Brandonh291/RC-Plane/README.md

# 3D Printed RC-Plane
This will be a full step-by-step production through all stages using systems engineering approach to create a 3D printed RC Plane.
