Brandonh291/RC-Plane/Systems Engineering/Pre-Phase A - Concept Studies/Pre-Phase A Concept Studies.docx

# Pre-Phase A: Concept Studies

Brandon Hickey

9/22/2023

Following: https://www.eng.auburn.edu/~dbeale/ESMDCourse/Chapter2.htm


# Purpose

The purpose of this section is to first create a list of ideas and concepts that satisfy the desired outcome and mission objectives. This will then be used in the 11 SE functions to derive a series of potential solutions.

# Systems Engineering Functions

Here I will attempt to go through each function and attempt to perform them at this stage.

## SE Function 1: Mission Objectives and Constraints

The goal of this project is to develop, design, and test a 3D printed remote-controlled aircraft capable of decent flight time and potential for payload. Due to the nature of the project, goals and requirements at this stage are ambiguous and lack many hard-set constraints. I will go through and list the current objectives and constraints and attempt to provide a range of required performance to then use moving forward in Phase A – Concept and Technology Development

## SE Function 2: Derived Requirements Development

### Project Objectives and Constraints List

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

### Identified Objectives and Constraints

- Made from 3D Printed Material.
- Individually printed pieces should not exceed 200mm x 200mm x 200mm.
- Aircraft wingspan to not exceed 1500mm.
- Electrical voltage will be either 2S or 3S Li-Po
- Aircraft Cruising speed: 9 – 13.5 m/s
- Vehicle weight less than 1,000 grams
- Thrust to weight ratio: 0.2 – 0.5.
- Motor Thrust: 200 – 500 grams
- Capable of flying for at least 10 minutes, 20 is preferred.
- Capable of carrying an extra 300-gram payload.

## SE Function 3: Architectural Design Development

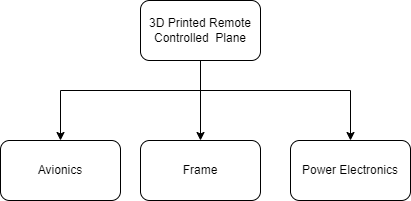
[picture p12: figure]

## SE Function 4: Concept of Operation


## SE Function 5: Validate and Verify

### Requirements Verification

To ensure we are satisfying our requirements, we will be performing basic calculations and testing to ensure we meet our requirements. This can include doing basic thrust and power calculations with a potential motor/prop combination to provide the desired T/W ratio as well as calculating our aircraft dimensions based on weight and desired speed.

### Systems Verification

We will be performing testing throughout development to ensure system operates safely and as expected. Such areas will include testing control surface directions and electronics wiring before the vehicle even approaches the runway.

### System Validation

Ensure that we are designing and developing according to the mission objectives and staying within our constraints.

## SE Function 6:

Not Completed, used later in Phase B.

## SE Function 7: Mission environment

Identify all environmental factors and potential concerns and exposures. For our aircraft we expect low winds (less than 10 mph), minimal weather.

## SE Function 8: Technical Resource Budget Tracking

Expected Budgets we plan to track during the project:

- Mass budget, this will help us keep track of the breakdown of object weights and where we might be able to trim potential issues.
- Cost Budget, keeping track of costs is important.
- Power Budget, this might be good to keep track of our power consumption to give a good breakdown of flight time estimation.

## SE Function 9: Risk Management

We will perform the following in the project.

- Seek and Identify risks.
- Determine risk severity and effect.
- Develop methods of risk mitigation

## SE Function 10: Configuration Management and Documentation

All content except Fusion360 files will be stored in GitHub. Project management will also be done through GitHub to maintain traceability. If Fusion360 files are added, they can be uploaded daily with provided changes.

## SE Function 11: System Milestone Reviews and Reports

As I am the stakeholder, my reviews are kind of to myself? I can mark milestones using GitHub to identify major areas of the project such as finishing phases and scheduled testing dates.
