Brandonh291/RC-Plane/Systems Engineering/Phase B - Preliminary Design and Technology Completition/Technical Resource Tracking.xlsx

Sheet: Mass Budget
Max Mass (g) | 1000
Current Total Mass | 1056.65
 |  |  |  |  |  | Aircraft Frame Part Weight
Subsystem | Avionics | Subsystem | Power | Subsystem | Aircraft Frame | Aircraft Wing |  | Aircraft Fuselage
Object | Mass (g) | Object | Mass (g) | Object | Mass (g) | Object | Mass (g) | Object | Mass (g)
FS-iA6B Receiver | 14.9 | D2830 1000KV Brushless Motor | 52 | Wings | 338.5 | Leading Edge | 34 | Nose | 67
SG90 Servo (4x) | 36 | 40A RC and 3A UBEC | 48 | Body | 447.25 | Trailing Edge | 12 | Middle | 104
 |  | 3S Lipo 2200mAh | 120 | Landing Gear | ? | Aileron | 33 | Inner Tail | 64
 |  |  |  |  |  | Rear Spar | 17 | Outer Tail | 31
 |  |  |  |  |  | Front Spar | 21 | Horizontal Stabilizers | 54
 |  |  |  |  |  | Ribs | 37 | Elevator | 21
 |  |  |  |  |  | End Cap Rib | 11 | 15.7 Inch 3mm Carbon Rod | 4.25
 |  |  |  |  |  | 15.7 Inch 3mm Carbon Rod | 4.25 | Fin and Rudder | 32
 |  |  |  |  |  |  |  | 1000mm x 8mm Carbon Tube x2 | 70
Total | 50.9 | Total | 220 | Total | 785.75 | Total | 338.5 | Total | 447.25

Sheet: Cost
Max Cost
Total Cost | 66.5
Subsystem | Avionics | Subsystem | Power | Subsystem | Aircraft Frame
Object | Cost ($) | Object | Cost ($) | Object | Cost ($)
FS-iA6B Receiver | 17
SG90 Servo (4x) | 10 | 40A RC and 3A UBEC | 22
 |  | 3S Lipo 2200mAh | 17.5
Total | 27 | Total | 39.5 | Total | 0
