Brandonh291/RC-Plane/Systems Engineering/Phase B - Preliminary Design and Technology Completition/Trainer Design Study.xlsx

Sheet: Plane Lift Study V1
Air Viscosity (kg/m/s) | 1.79e-05
Air Density (kg/m/m/m) | 1.225
Lift | S7055 Flatbottom
Reynolds Number | Alpha = 0 deg | Alpha = 5 deg | Alpha = 10 deg
50000 | 0.0812 | 0.6619 | 1.2661
100000 | 0.3952 | 0.8992 | 1.2615 |  |  |  |  |  | Here we will make all Lift greater than 1 kg (9.81 N) equal to yellow, to indicate a possible cruising condition at 1 kg plane weight
200000 | 0.4304 | 0.9118 | 1.2591 |  |  |  |  |  | We will mark anything greater than 13 N as green to indicate that it can handle the full 1kg plane and 300 gram payload
 |  |  |  |  |  |  |  |  | Aspect Ratio 5, Lift By Wingspan @ 9 m/s cruising
250 mm Wingspan |  |  |  |  |  |  |  |  | Wingspan (mm) | 9m/s Lift (N) @ Alpha = 0 | 9m/s Lift(N) @ Alpha = 5 | 9m/s Lift(N) @ Alpha = 10
Inputs |  |  | Outputs |  |  |  |  |  | 0.25 | 0.0503566875 | 0.4104814219 | 0.7851798281
Wingspan (m) | Wing Aspect Ratio | Cruising Speed (m/s) | Average Wing Chord (m) | Wing Area (m^2) | Reynolds Number | Lift (N) @ Alpha = 0 | Lift(N) @ Alpha = 5 | Lift(N) @ Alpha = 10 | 0.5 | 0.20142675 | 1.641925688 | 3.140719313
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
