Brandonh291/RC-Plane/Systems Engineering/Phase B - Preliminary Design and Technology Completition/Trade Study.xlsx

Criteria | Weight | Opt. #1 Twin Boom, One Engine |  | Opt. #2 Twin Boom, Two Engine |  | Opt. #3 Trainer, High-wing, Single Engine |  | Opt. #4 C130 Style, High-Wing, Two Engine |  | Criteria | Weight | Twin Boom 1E | Twin Boom 2E | Trainer 1E | Trainer 2E
 |  | Rating (1-5) | Score | Rating (1-5) | Score | Rating (1-5) | Score | Rating (1-5) | Score |  |  | Score | Score | Score | Score
Expected Ease of Designing | 15 | 2 | 6 | 1 | 3 | 4 | 12 | 3 | 9 | Expected Ease of Designing | 15 | 6 | 3 | 12 | 9
Expected Ease of Manufacturing | 10 | 3 | 6 | 2 | 4 | 4 | 8 | 3 | 6 | Expected Ease of Manufacturing | 10 | 6 | 4 | 8 | 6
Expected Ease of assembling | 15 | 2 | 6 | 1 | 3 | 3 | 9 | 2 | 6 | Expected Ease of assembling | 15 | 6 | 3 | 9 | 6
Durability/Rigidity | 10 | 4 | 8 | 3 | 6 | 4 | 8 | 3 | 6 | Durability/Rigidity | 10 | 8 | 6 | 8 | 6
Maneuverability | 10 | 4 | 8 | 5 | 10 | 3 | 6 | 3 | 6 | Maneuverability | 10 | 8 | 10 | 6 | 6
Aesthetic/Personal Taste | 5 | 3 | 3 | 4 | 4 | 2 | 2 | 4 | 4 | Aesthetic/Personal Taste | 5 | 3 | 4 | 2 | 4
Stability | 15 | 3 | 9 | 3 | 9 | 4 | 12 | 4 | 12 | Stability | 15 | 9 | 9 | 12 | 12
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
