Brandonh291/RC-Plane/Systems Engineering/Phase B - Preliminary Design and Technology Completition/Specifications.xlsx

Phase-B Specifications
Specification | Value | Unit
Material | 3D Printed (PLA / LW-PLA) | N/A
Individual Part Size | <200 x 200 x 200 | millimeters
Wingspan | <1500 | millimeters
Battery | 3S Lipo | N/A
Cruising Speed | 9 - 17 | meters per second
Aircraft Weight | <1000 | grams
Thrust to Weight Ratio | 0.2 - 0.5 | N/A
Flight Time | 10 - 20 | minutes
Payload Capacity | ~300 | grams
Runway Take-off Length | <50 | meters
