Brandonh291/RC-Plane/Systems Engineering/Phase B - Preliminary Design and Technology Completition/Fusion360 Versions/3D Models/Version 1/Fuselage/Fuselage_Nose.stl

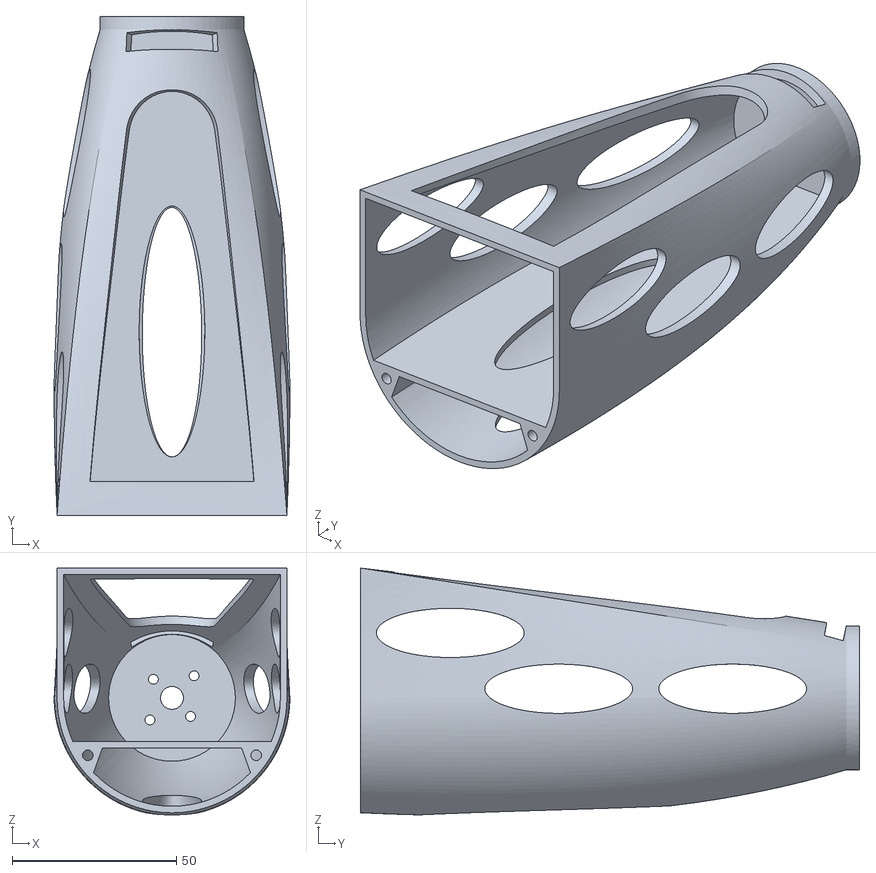
[picture p13: CAD file, 2023-10-05]
Systems Engineering/Phase B - Preliminary Design and Technology Completition/Fusion360 Versions/3D Models/Version 1/Fuselage/Fuselage_Nose.stl
71.8 x 152.0 x 75.2
