Brandonh291/RC-Plane/Systems Engineering/Phase B - Preliminary Design and Technology Completition/Fusion360 Versions/3D Models/Version 1/Fuselage/Tail/Front Tail.stl

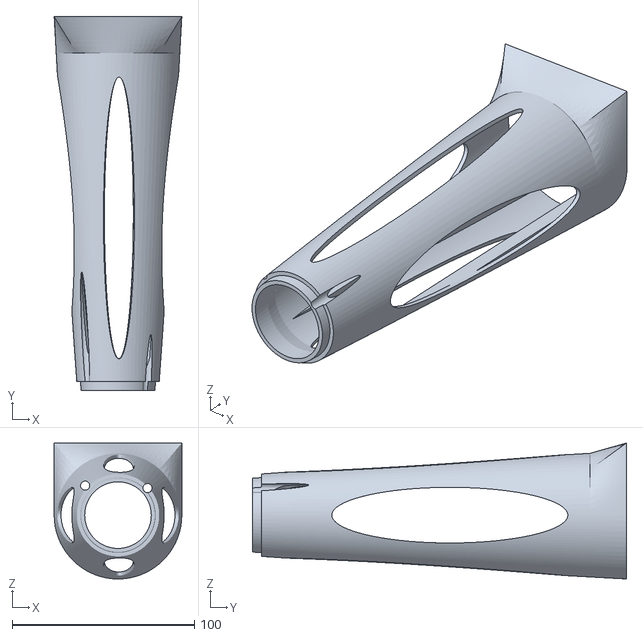
[picture p14: CAD file, 2023-10-05]
Systems Engineering/Phase B - Preliminary Design and Technology Completition/Fusion360 Versions/3D Models/Version 1/Fuselage/Tail/Front Tail.stl
70.0 x 205.0 x 74.5
