Brandonh291/RC-Plane/Systems Engineering/Phase B - Preliminary Design and Technology Completition/Fusion360 Versions/3D Models/Version 1/Fuselage/Tail/Horizontal Stabilizer/Left Stab.stl

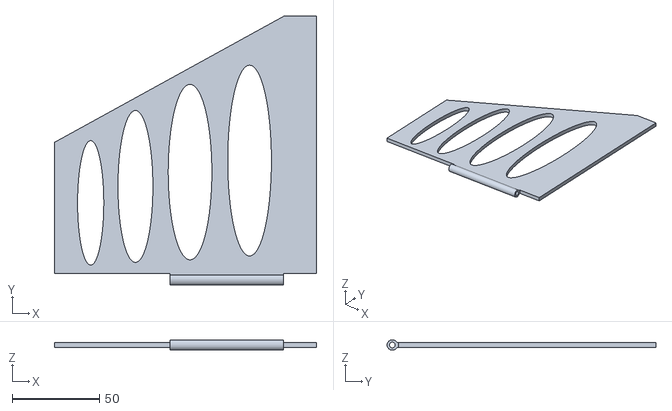
[picture p15: CAD file, 2023-10-05]
Systems Engineering/Phase B - Preliminary Design and Technology Completition/Fusion360 Versions/3D Models/Version 1/Fuselage/Tail/Horizontal Stabilizer/Left Stab.stl
150.0 x 153.9 x 6.00
