Brandonh291/RC-Plane/Systems Engineering/Phase B - Preliminary Design and Technology Completition/Fusion360 Versions/3D Models/Version 1/Fuselage/Tail/Vertical Stabilizer/Rudder.stl

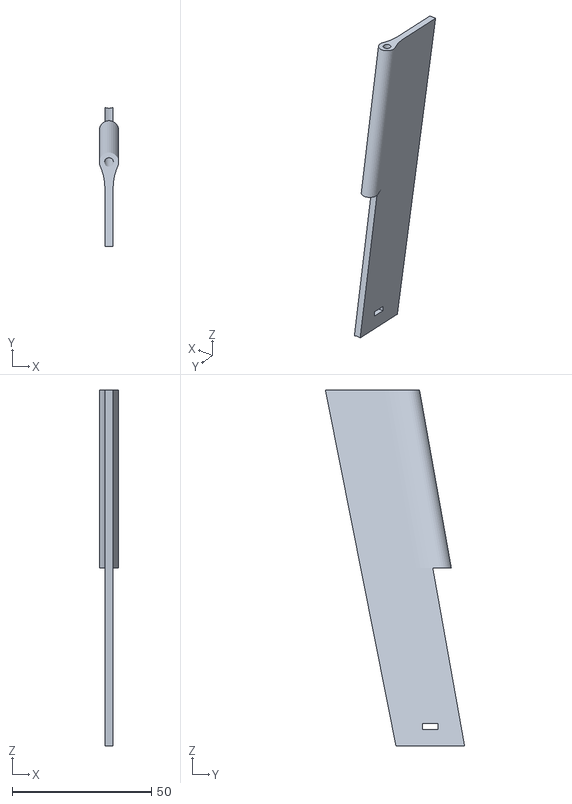
[picture p16: CAD file, 2023-10-05]
Systems Engineering/Phase B - Preliminary Design and Technology Completition/Fusion360 Versions/3D Models/Version 1/Fuselage/Tail/Vertical Stabilizer/Rudder.stl
7.00 x 50.1 x 128.0
