Brandonh291/RC-Plane/Systems Engineering/Phase B - Preliminary Design and Technology Completition/Fusion360 Versions/3D Models/Version 1/Left Wing/Left Aileron.stl

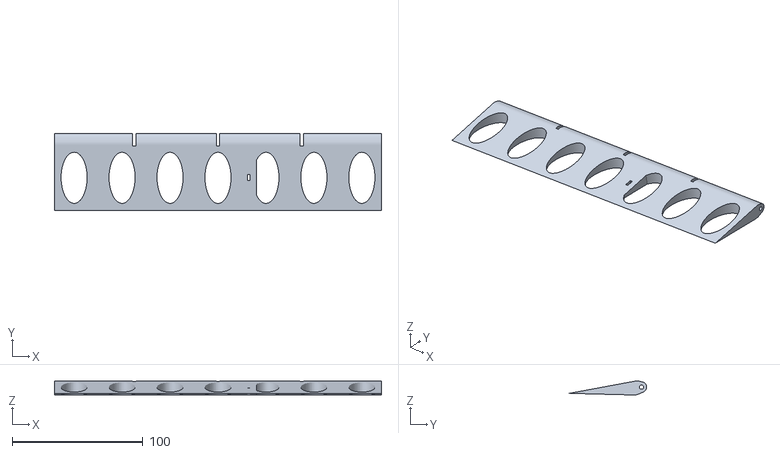
[picture p17: CAD file, 2023-10-05]
Systems Engineering/Phase B - Preliminary Design and Technology Completition/Fusion360 Versions/3D Models/Version 1/Left Wing/Left Aileron.stl
250.0 x 59.1 x 10.7
