Brandonh291/RC-Plane/Systems Engineering/Phase B - Preliminary Design and Technology Completition/Fusion360 Versions/3D Models/Version 1/Fuselage/Tail/Horizontal Stabilizer/Right_Elevator.stl

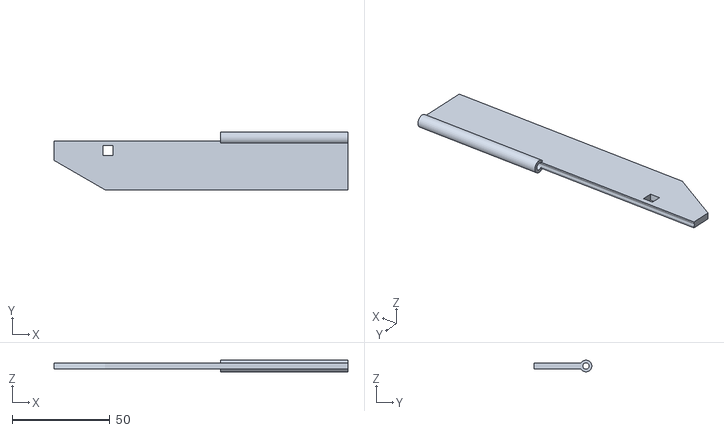
[picture p20: CAD file, 2023-10-05]
Systems Engineering/Phase B - Preliminary Design and Technology Completition/Fusion360 Versions/3D Models/Version 1/Fuselage/Tail/Horizontal Stabilizer/Right_Elevator.stl
150.0 x 29.4 x 5.99
