Brandonh291/RC-Plane/Systems Engineering/Phase B - Preliminary Design and Technology Completition/Fusion360 Versions/3D Models/Version 1/Left Wing/Left_Rear_Spar_Middle.stl

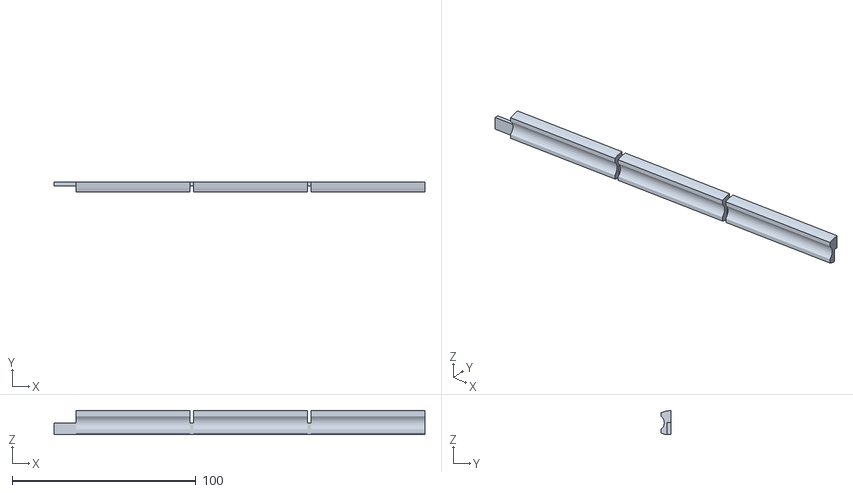
[picture p24: CAD file, 2023-10-05]
Systems Engineering/Phase B - Preliminary Design and Technology Completition/Fusion360 Versions/3D Models/Version 1/Left Wing/Left_Rear_Spar_Middle.stl
201.9 x 5.36 x 13.2
