Brandonh291/RC-Plane/Systems Engineering/Phase B - Preliminary Design and Technology Completition/Fusion360 Versions/3D Models/Version 1/Right Wing/Right_Front_Spar_Mid.stl

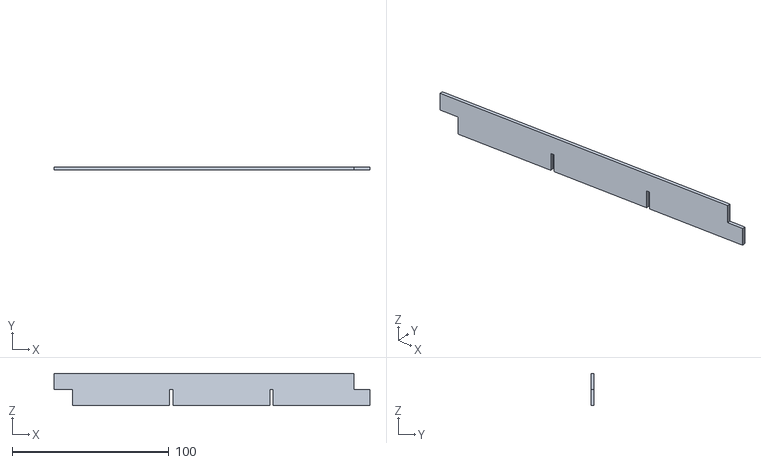
[picture p25: CAD file, 2023-10-05]
Systems Engineering/Phase B - Preliminary Design and Technology Completition/Fusion360 Versions/3D Models/Version 1/Right Wing/Right_Front_Spar_Mid.stl
201.9 x 2.00 x 20.5
