Brandonh291/RC-Plane/Systems Engineering/Phase B - Preliminary Design and Technology Completition/Fusion360 Versions/3D Models/Version 1/Fuselage/Tail/Horizontal Stabilizer/Elevator_Merge.stl

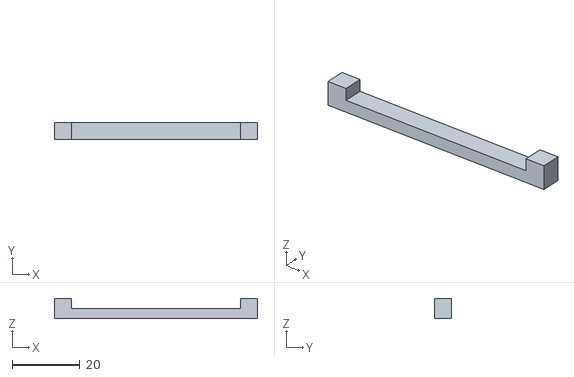
[picture p27: CAD file, 2023-10-05]
Systems Engineering/Phase B - Preliminary Design and Technology Completition/Fusion360 Versions/3D Models/Version 1/Fuselage/Tail/Horizontal Stabilizer/Elevator_Merge.stl
60.0 x 5.00 x 6.00
