Brandonh291/RC-Plane/Systems Engineering/Phase B - Preliminary Design and Technology Completition/Fusion360 Versions/3D Models/Version 1/Left Wing/Left_TE_Mid.stl

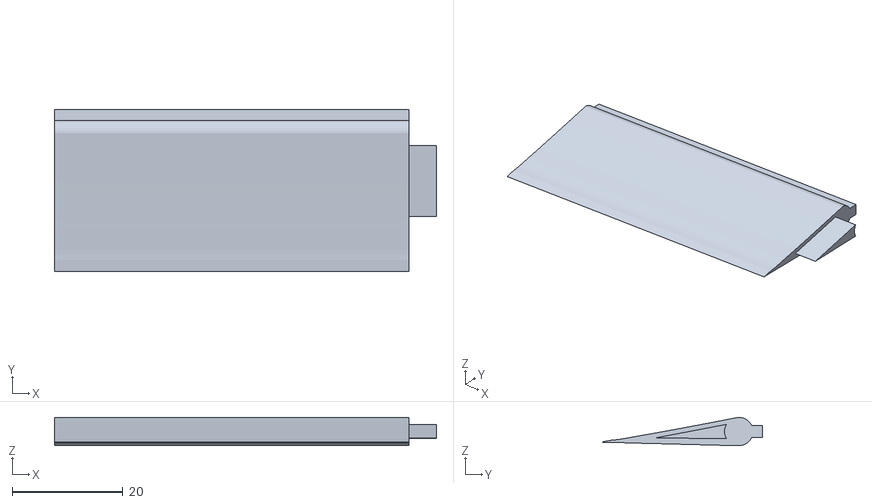
[picture p29: CAD file, 2023-10-05]
Systems Engineering/Phase B - Preliminary Design and Technology Completition/Fusion360 Versions/3D Models/Version 1/Left Wing/Left_TE_Mid.stl
69.0 x 29.3 x 5.14
