Brandonh291/RC-Plane/Systems Engineering/Phase B - Preliminary Design and Technology Completition/Fusion360 Versions/3D Models/Version 1/Right Wing/Right_Rear_Spar_Inner.stl

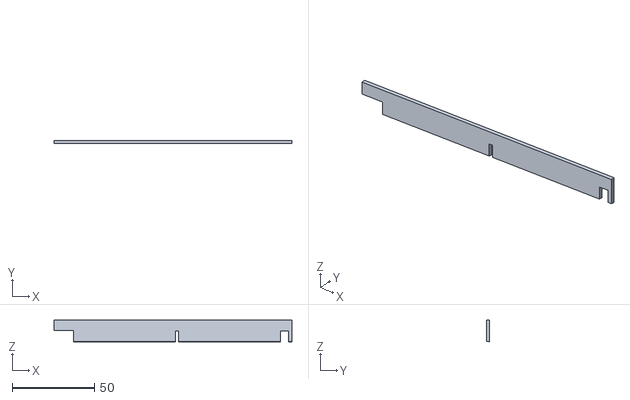
[picture p30: CAD file, 2023-10-05]
Systems Engineering/Phase B - Preliminary Design and Technology Completition/Fusion360 Versions/3D Models/Version 1/Right Wing/Right_Rear_Spar_Inner.stl
144.9 x 2.00 x 13.2
