Brandonh291/RC-Plane/Systems Engineering/Phase B - Preliminary Design and Technology Completition/Risk Assessment.xlsx

Sheet: Code List
Code | Name | Description
4 | Mission Failure | If this error cannot be mitigated, the mission will be a failure.
3 | Reduced Lifetime | If this error cannot be mitigated, the mission is still a success, but further research is needed to extend mission liftime in future missions.
2 | Reduced Capabilitity | If this error cannot be mitigated, the mission is still a success, but further research is needed to provide increased capability
1 | Non-Critical | If this error cannot be mitigated, the mission could still be accomplished without additional needs for redundancy

Sheet: Avionics Sys. Failure Modes
Part | Failure | Code | Effect | Mitigation
Radio System Failure | Out of Range | 4 | Loss of Communication | Ensure we do not exceed a defined flight distance.
 | Low Voltage | 4 | Loss of Communication | Check battery levels and estimate battery life to a timed amount to know when to land.
 |  |  |  | I can also set the servos to lock on lack of signal to have the plane attempt to glide straight forward to prevent total failure.

Sheet: Power Sys. Failure Modes
Part | Failure | Code | Effect | Mitigation
Motor Failure | Propellor Breaks | 3 | Loss of thrust | Ensure that aircraft is not flown into potential objects that coulddamage the propellor
 | Over-current | 4 | Fire Hazard | Ensure power rating of ESC is suitable to power demands
Battery Failure | Low Voltage | 4 | Loss of Control | Check battery levels and estimate battery life to a timed amount to know when to land.
 | Overheat | 4 | Fire Hazard | Ensure proper ventilation and heat dissipation
Servo Failure | Loss of Power | 4 | Partial Control Loss | Check battery levels and estimate battery life to a timed amount to know when to land.
 | Disconnected Wiring | 4 | Loss of control | Check wirings before flight and secure.
 | Reversed control surfaces | 3 | Partial Control Loss | Check wirings before flight and secure.

Sheet: Aircraft Sys. Failure Modes
Part | Failure | Code | Effect | Mitigation
Body Failure | Connections fall apart | 4 | Loss of Control | Confirm all adhesion of parts and test durability
Wing Failure | Insufficient Lift | 3 or 4 | Lack of sufficent lift | Vehicle will not be able to take off from runway, decrease weight or increase wing area
Control Surface Failure | Loss of Control | 3 | Partial or total lack of control | Ensure parts operate correctly with the correct sizing and control rod length
