Brandonh291/RC-Plane/(threads)

Thread 1 (2023-09-22):

Pre-Phase A: Concept Studies

Brandonh291, 2023-09-22:
Purpose: To produce a broad spectrum of ideas and alternatives concepts.

Brandonh291, 2023-09-22:
Currently in a rough-draft form. Probably need to review again with the Pre-Phase A Section, will need to create another issue once I close and merge this with the branch.

Closed 2023-09-22.

Thread 9 (2023-09-24):

Plane Design

Brandonh291, 2023-09-24:
Start on plane design

Brandonh291, 2023-09-24:
Begun development of plane specs. Needs simulation to determine operating characteristics. Might need to look into how to calculate life and drag of a plane fuselage. However I lack the current shape of the fuselage so I might consider it something like a cylinder or cone for simplicity.

Closed 2023-10-05.

Thread 11 (2023-09-26):

Wing Design

Brandonh291, 2023-09-26:
Trying to get the wing design finished, will be doing prototyping to determine feasibility for a alternating rear and forward spar pattern, no carbon rod.

Brandonh291, 2023-09-26:
Currently testing new wing design.

Brandonh291, 2023-09-29:
So far, printed most of the wing and I will need to make the following revisions.

1. Make the spaces between the spars larger. Right now its either a 2mm or 3mm space, which makes a space that can bend easily and break faster. While I don't think its going to be a major issue since the spares should keep it from bending around that point, likely a failure point nonetheless.

2. It might be lower weight to use only half the spars and use a carbon fiber rod. The issue with the rods is that I need to use atleast 3 rods give they are about 14-16 inches long and the wingspan is 40 inches. This means I need to either bond rods together in a way that wont become a point of breakage, or use twice the rods in an alternating fashion like I am doing with the spars. I will check the weight of the wing after I have completed all the spars and compare that with a few options: 4 spars & no rods, 2 spars and 1 Rod, and 2 Spars with 2 rods. I need the spars to get the spacing for the wing ribs and I think I plane to use the spars as a way to mount my aileron control servos. Though, in previous designs , I was able to mount a servo using two rods instead, but that became an issue with printing and keeping it in place.

3. Adjustments to aileron print need to be made. Most of the piece is good, but the printer is struggling to keep the holes for the rotation points of the aileron from collapsing. I will look at tuning the printer, and maybe adjusting print orientation.

4.  I still need to figure out the leading and trailing edge. My current idea is to use a slightly thicker tape or material like paper or painters tape or duct tape to use one long piece along the trailing and leading edge. This gives a unified form for each part and would give more material for my skin to connect to.

5. I also need to adjust the end spars and end rib to become something like an end cap. The sharp cut-off probably does not create a huge effect at this low of speed. However, I believe the end cap will provide a better connection on the last spar, and I can use it as a larger skin space for attaching the skin. Plus it technically could be a nice bevel off to also house any excess rods I might use, and wingtip vortices.

Brandonh291, 2023-09-29:
Wing design, the alternating spars do not provide the needed strength. Just holding one end of the wing on the table and letting the rest hang over the edge causes a drop of 400 mm or a bend of 25 degrees under its own weight. So I am going to look at just doing carbon fiber rods instead with a alternating set and use the spars as only a single set rear and front being offset from each other to keep spacing correct. I honestly might trim off the edge of the airfoil trailing edge because it is a pain to print and I might be able to add a trail edge piece with the weight saved from removing the spars.

Brandonh291, 2023-09-29:
I am going to make a new wing file and attempt to start semi-scratch to change to a two-spar/2 rod system and keep this 4 rod version up as a separate version just so its not overwritten.

Brandonh291, 2023-09-29:
I also plan to still test the endcap and spar hook because I can end the rods inside the end cap and its good end joiner piece for the spars that remain.

Closed 2023-10-05.

Thread 13 (2023-10-05):

Plane Prototyping

Brandonh291, 2023-10-05:
Now printing the first set of designs to see what revisions need to be made.

Brandonh291, 2023-10-06:
Started First Prints

Brandonh291, 2023-10-11:
Version 1 Results:

1. Lack of landing gear mounting points for fuselage
2. No testing done on fin/rudder and stabilizer/elevators. Did increase hole size for fixing rod as it seemed small in other prints
3. Inconvenience with connecting wing parts together, hole for carbon rod was a bit small which would become an issue once the skin is attached when we need to run rod through for mounting wings to fuselage
4. Trailing Edge was too small and would not print correctly, issues also in joining sections to each other then to the wing also were apparent.

Planes for Version 2:

1. Add mounting points for landing gear, include servo slot at nose for front gear to make steerable during taxi.
2. Make carbon rod holes larger on wing ribs, might become loose but that can be fixed with painters tape and screwing wings to fuselage. Goal is to make sure that the rod can easily be joined with wings after skin is attached.
3. Increase size of trailing edge to make joining easier.

Once additions are made, print parts starting with one wing and attempt joining. Also print Fuselage for testing landing gear and control surfaces. I have a feeling that the rear tail might need some work in terms of keeping stabilizer and fin on, but superglue might work fine.

Brandonh291, 2023-10-13:
Added finite wing performance, did not seem to make much of a difference. I am talking like less than a percent of difference at my aspect ratio. and the percent error is really only less than 10% around -1 to 3 degrees AoA.

But now I wonder if that sfine, there will be a difference in performance obviously for the difference in wing. It would be cool to check out a wind tunnel result for a finite airfoil section and see what the result is and compare that to this calculation.

Brandonh291, 2023-10-13:
Testing on Version 2 of design is going well, most parts of Left Wing are finished and appear to be joined well. I made a slight revision to Servo Mount to create space for wires. Small change did not warrant a new version number. If you wanted I would call it a V2.1 but I don't know how version control works in that way so to me its just Version 2.

Brandonh291, 2023-10-13:
Left Wing Aileron is a little sticky in the joints, I used my carbon rods for the joints and slide it back and forth to sand the clamp down. I plan to sand down the socket where the aileron rotates around as it currently slides against the rear spar.

**Improvement for Version 3: Expand the size of the Rear Spar Socket to reduce friction generated by 3d printing.**

Brandonh291, 2023-10-20:
So I am currently assembling all the pieces now. Something I noticed was that the rear tail piece does not have a good way to snap the stabilizer and fins in a set place. Instead I had left it just to slide in and lock together. With the printing process that makes it hard to get correct.

**Improvement for Version 3: Make the rear tail fin and stabilizers have a better method of locking together and to the rear tail to make assembly less prone to error. Might be good to have better slots built in and close off the end of the tail so its not just and open piece that can bend easily.**

Brandonh291, 2023-10-20:
The tolerances for the middle landing gear on the main body of the fuselage is a bit tight. I will be able to fix it with sanding but definitely needs some improvement.

**Improvement for Version 3: Increase tolerance for landing gear mounting point.**

Brandonh291, 2023-10-26:
Wings are finished with vinyl, they appear to go well, a little sticky on the ailerons but I believe that will wear-in with use.

All servo slots on main fuselage require a slot for wiring, currently requires a large amount of sanding to get them to fit.
**Improvement for Version 3: Wire Slot Cutouts for all servos in Fuselage**

Hole for nose landing gear is a bit big, makes the fit a bit loose. Can tighten this up a bit or include something like tape or something around the mount to make it more snug.
**Improvement for Version 3: Decrease hole size for nose landing gear.**

There is a gap between the floor of the mid fuselage and the outer walls where the mount screw goes through, this could be made solid to add more bite.
**Improvement for Version 3: Add solid material for main landing gear mounts.**

Brandonh291, 2023-10-30:
Plane is about done, just need to add screws to the servo gears and test weight balancing with wings attached as well as Aileron Directions.

Areas of improvement:
1. Main Landing Gear Placement,  its a bit too far forward I believe, so my balance is going to be a bit precarious. Shift it back further.
2. Make a flattened area for the nose landing gear lock nut to sit against the outside nose of the plane. Right now it allows it to bend which is problematic.
3. Get shorter screws for middle landing gear. Right now the screws protrude heavily into the workspace of my electronics.
4. Find a better method of attaching motors, right now it was a pain getting just the top two screws on. Might be solved with a flexible screw attachment.
5. I need to make some sort of side cuts or access panels in the plane nose to tighten the landing gear screws, I had to punch through the vinyl to get to them.
6. Slot or access point for RC antenna, I have it poking out of the vinyl for now.
7.

Potential Edits:
1. Maybe like making the motor and ESC mount a piece that can be connected and disconnected from the main body, makes things easier potentially.
2. Add weights into Fusion360 to get a better idea for CG placement.
