Brandonh291/RC-Plane/(commit log)

2023-09-21 added trade study excel, first draft
    [Trade Study.xlsx]
2023-09-22 Update Trade Study.xlsx
    [Trade Study.xlsx]
2023-09-22 Pre-Phase A and Phase-A Development
    I have created a rough-draft Pre-Phase A: Concept Studies and rough-draft Phase A: Concept Development and Technology. I am continuing work on Phase-A documentation and once I have gotten the the word document finished with I will move back to main branch.
    [Trade Study.xlsx]
2023-09-22 Added Budget
    Added mass and cost budget excel
    [Technical Resource Tracking.xlsx]
2023-09-23 Adjusted Cost Budget
    Since I have not decided on some components I removed them from the tracking for now.
    [Technical Resource Tracking.xlsx]
2023-09-23 Excel Adjustments
    Trimmed size down for ease of adding to documentation.
    Also added risk assessment with all sections currently known and implemented them into the general documentation.
    This should be good to go in terms of moving on i believe.
    [Risk Assessment.xlsx, Technical Resource Tracking.xlsx]
2023-09-24 Edits to Documentation, Trade Study
    Completed 3 trade studies: 2 lift and 1 drag. This is to determine the potential plane size options.
    This is written into the word document.
    Next up will be simulating take-off to get a better feel for the required power for engine selection.
    [Risk Assessment.xlsx, Technical Resource Tracking.xlsx, Trade Study.xlsx, Trainer Design Study.xlsx]
2023-09-26 Add fusion360
    Testing out the first style of wing/spar/rib combo . Printing some test pieces to determine if this will work or not.
    [Wings v1.f3d]
2023-09-26 New Wing Version and Test Prints
    Trying out some new versions with an over-under alternation to try and remove need for carbon fiber rods, will have to look if it saves weight or not. I know I can drop some grams on the spars by cutting excess material and placing some lightning holes like I did the ribs.
    [Rib_L4.stl, Rib_L9.stl, Spar_RI1.stl, Spar_RO1.stl, Spar_RO3.stl, Wings v1.f3d, Wings v2.f3d]
2023-09-27 adjustments to documentation
    [Specifications.xlsx]
2023-09-28 Added new export files for print testing
    Printing out ribs and spars, along with aileron for testing. I know I want to throw something on the ends of the aircraft to seal the skins in. I am thinking something like a rounded cap that also connects to the edge spars. This way it helps secure those edges on full.
    I also must start working on the development of the servo mounts now. I am going to probably create a new component inside the wings file for the control horn, based on already done measurements, then attach it to determine how my servo arm will fit.
    [Rib_M.stl, Rib_R3.stl, Rib_R7.stl, Rib_R9.stl, Right Aileron.stl, Spar_FI1.stl, Spar_FI2.stl, Spar_FI3.stl]
2023-09-29 Update Phase B - Preliminary Design and Technology Completition.docx
    Added update to the documentation and RC Wing Design Issue in github
2023-09-29 adustments and printing endcaps
    [Rib_L9.stl, Rib_R9.stl]
2023-10-01 Fusion360 Work
    Wings are coming along nicely, got first test prints going, documentation added.
    [Body1.stl, Body2.stl, Body3.stl, LE_M.stl, LE_Mid.stl, LE_Start.stl, L_Rib_2.stl, aileron.stl]
2023-10-03 edits and testing
    [Body13.stl, Body2.stl, Body8.stl, Fuselage_Nose.stl, L_Rib_1.stl, L_Rib_4.stl, Left Aileron.stl, Rear_Spar_Middle.stl]
2023-10-04 testing parts
    [Front Tail.stl, FuselageMid.stl]
2023-10-05 Finished First Prototype Design
    Must begin printing to test it
    [Body1.stl, Body13.stl, Body2.stl, Body3.stl, Body8.stl, Fin.stl, Front Tail.stl, FuselageMid.stl]
2023-10-05 Adjustments to Files
    We have removed previous gcode test files, and have completely added a full list of the first prototype 3D models.
    Added to the resource tracking excel sheet with the expected weights of all parts and 3D printed components with the exception of the landing gear.
    Filled in status notes in the overall documentation file.
    [Body1.stl, Body13.stl, Body2.stl, Body3.stl, Body8.stl, Elevator_Merge.stl, Fin.stl, Front Tail.stl]
